mcous/beer2d2/pcb/r2dbrew-front-pcb/r2dbrew-front-pcb.pdf

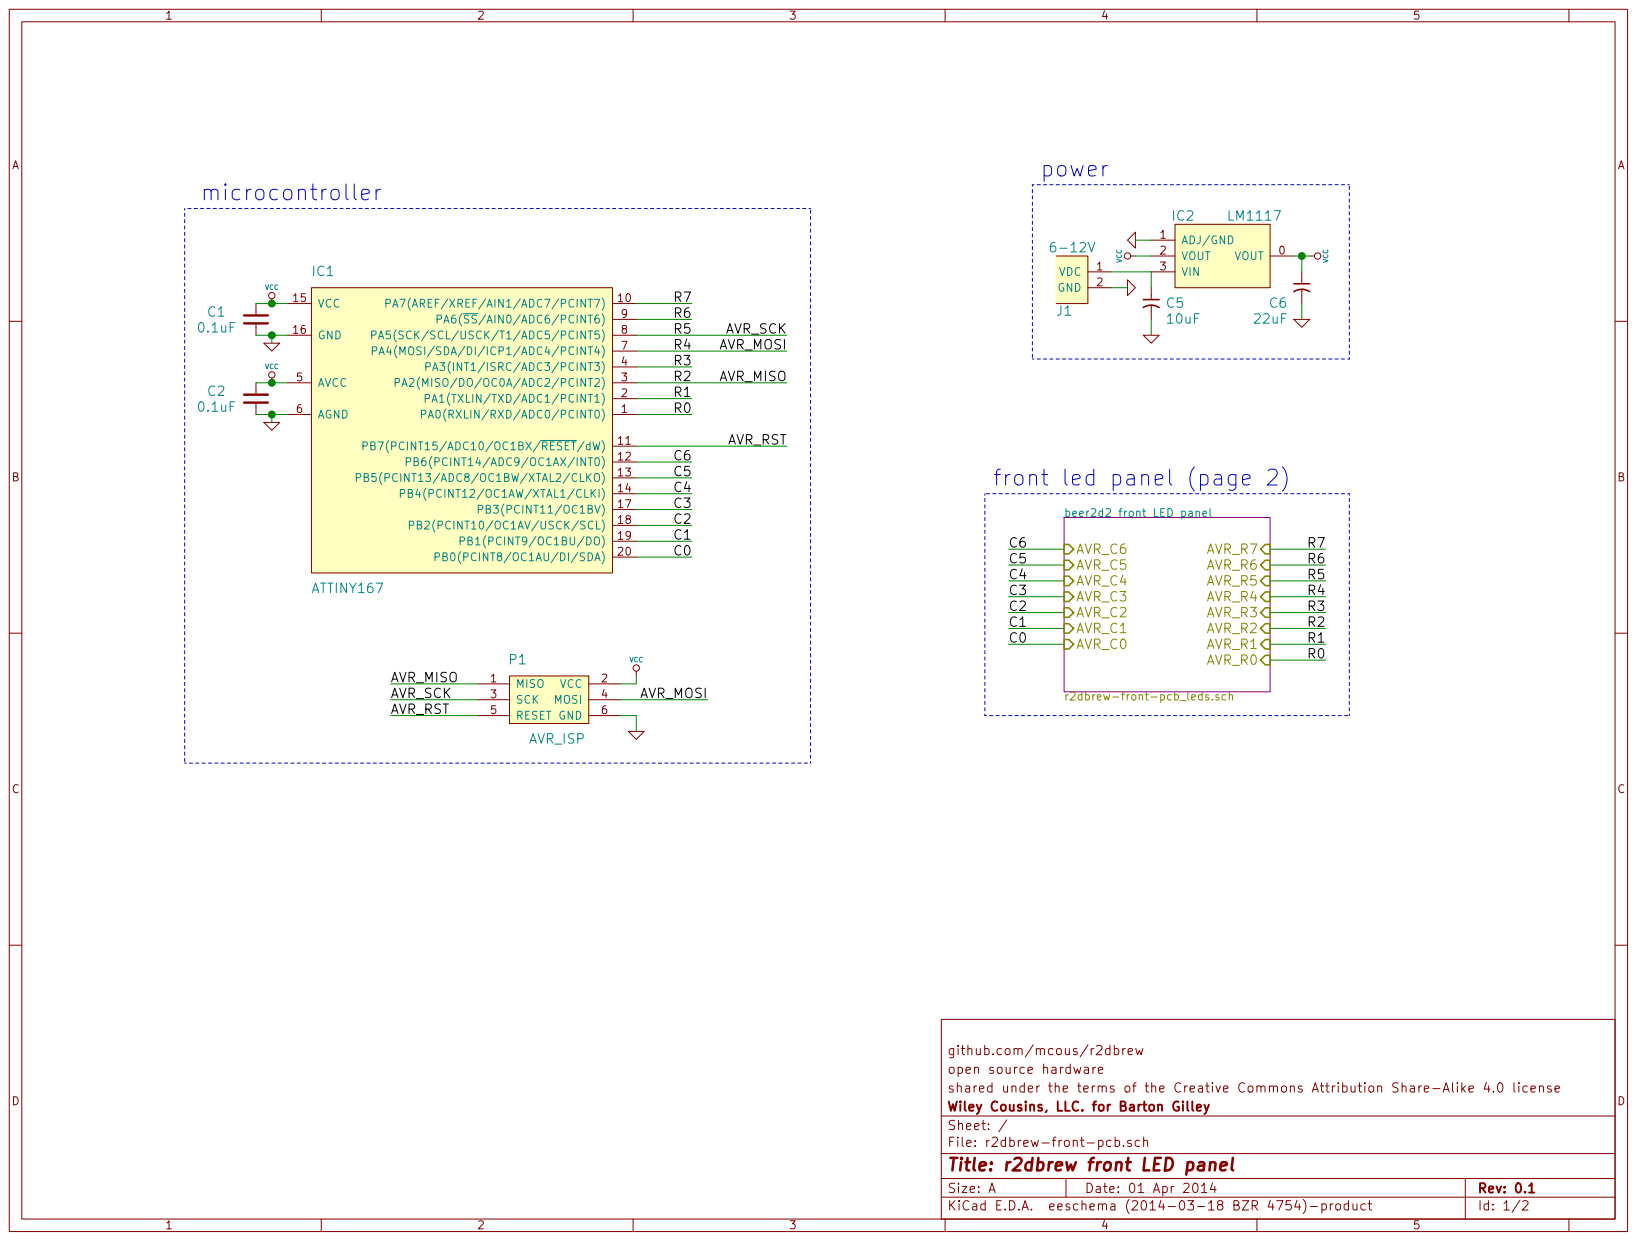
[picture p1: page 1]

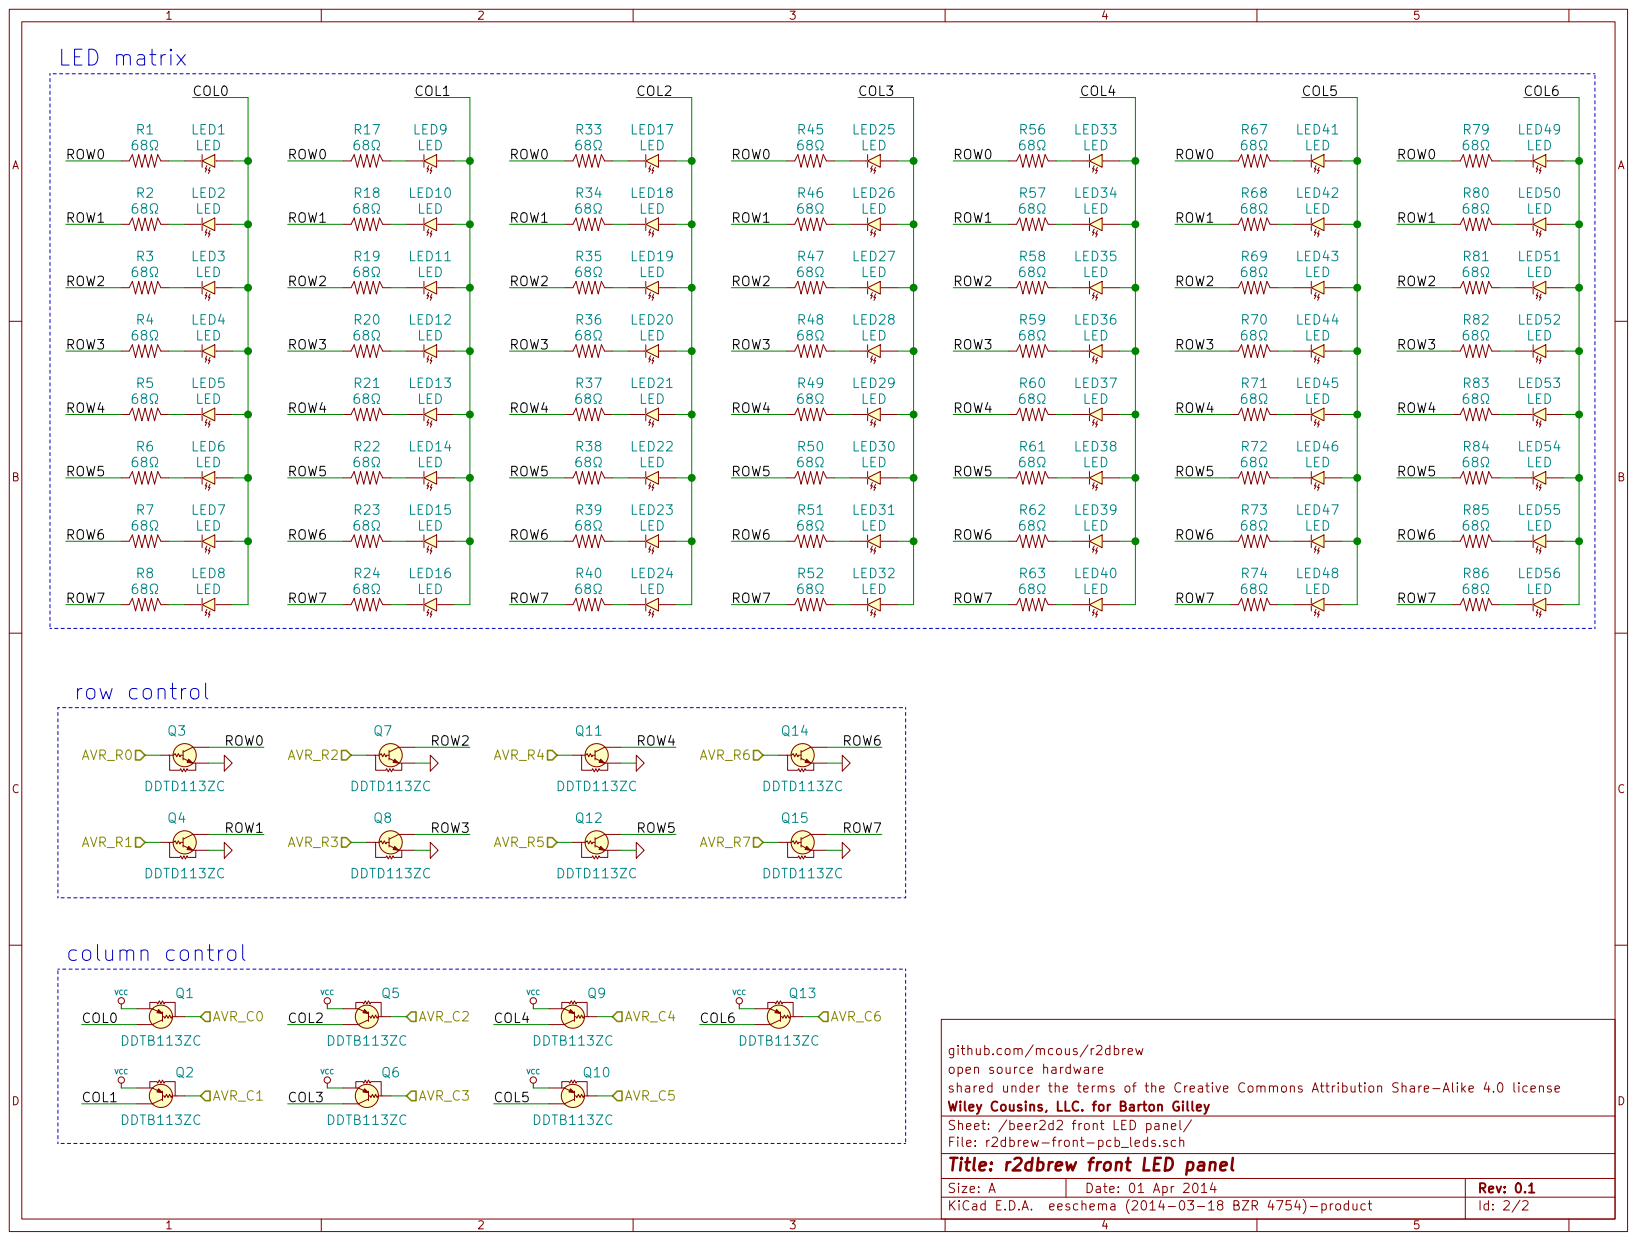
[picture p2: page 2]
