mcous/beer2d2/pcb/r2dbrew-back-pcb/r2dbrew-back-pcb.pdf

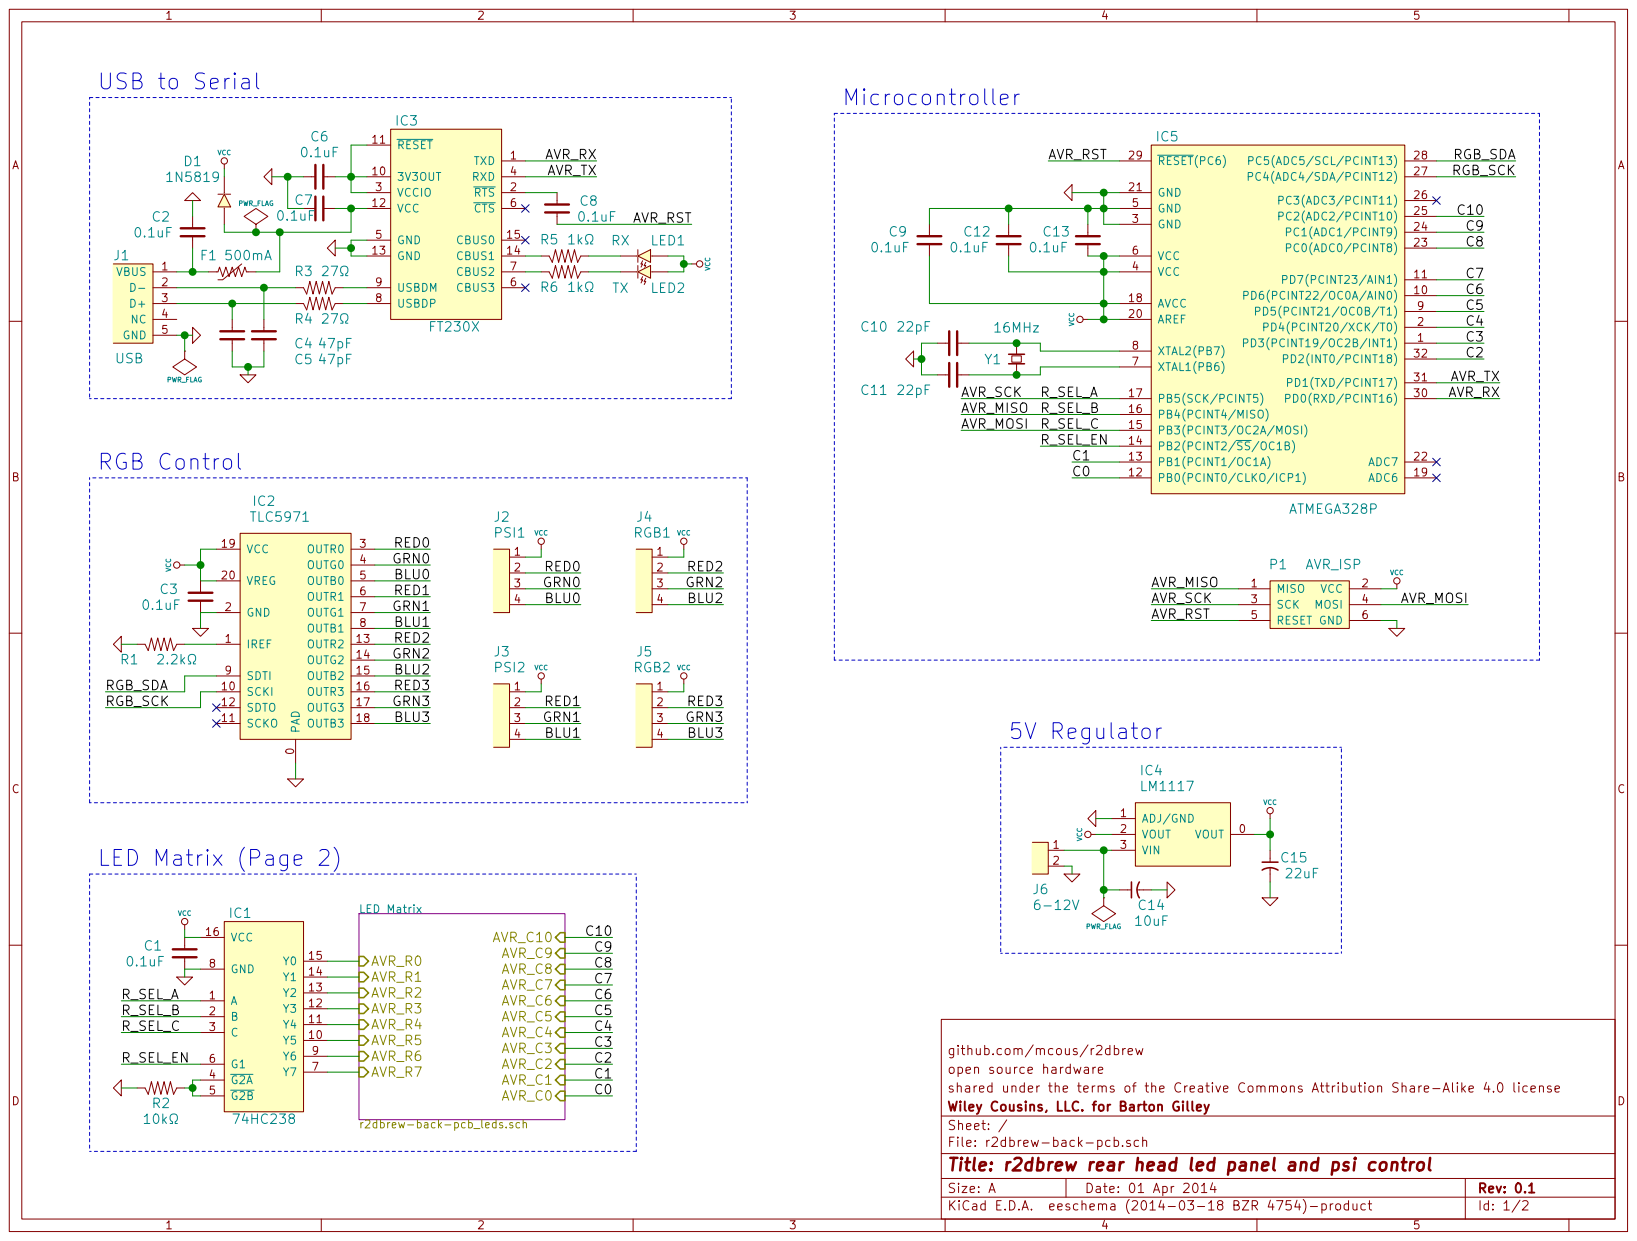
[picture p3: page 1]

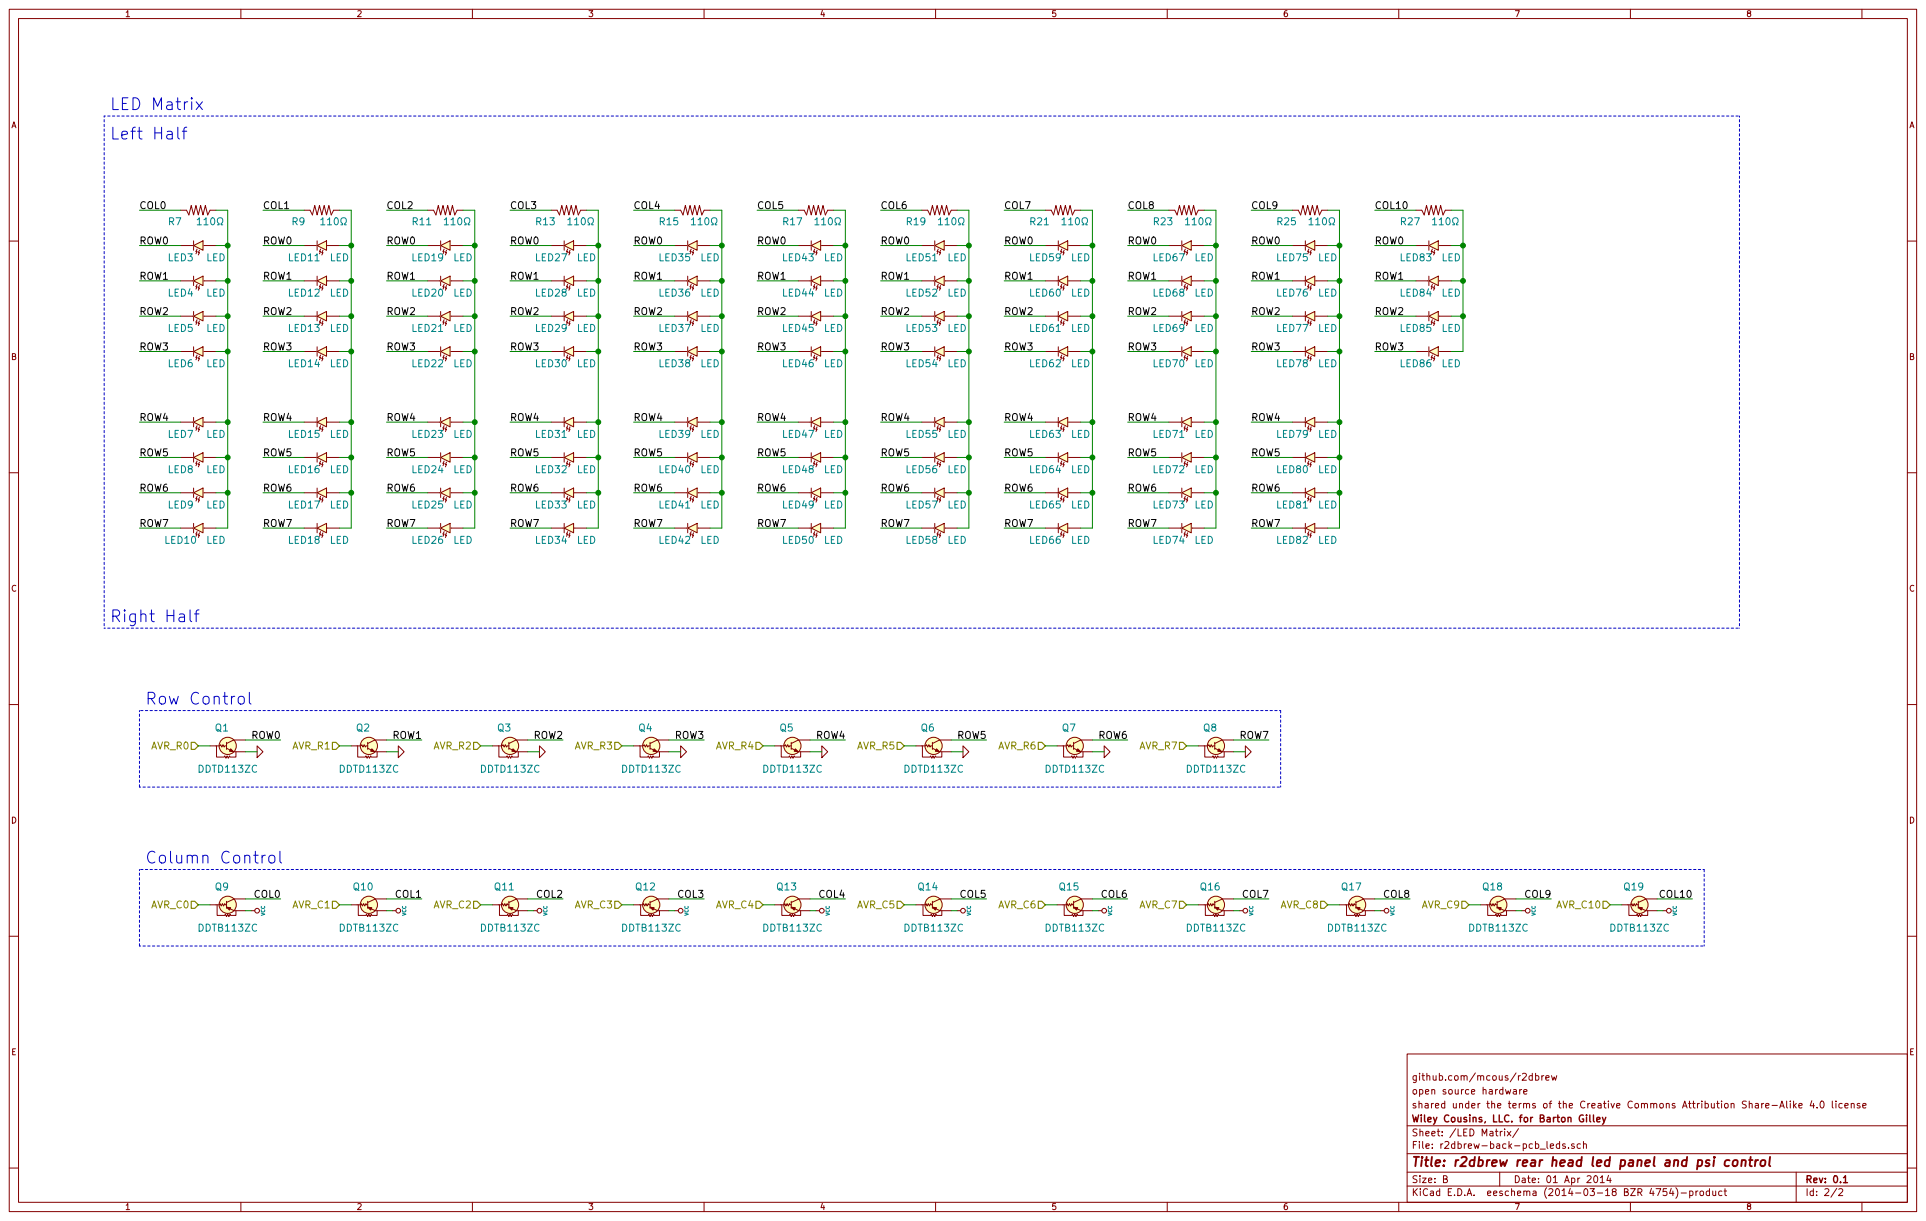
[picture p4: page 2]
