mcous/beer2d2/pcb/r2dbrew-back-pcb/r2dbrew-back-pcb.kicad_pcb

## KiCad design pcb/r2dbrew-back-pcb/r2dbrew-back-pcb.kicad_pcb (2014-05-03)

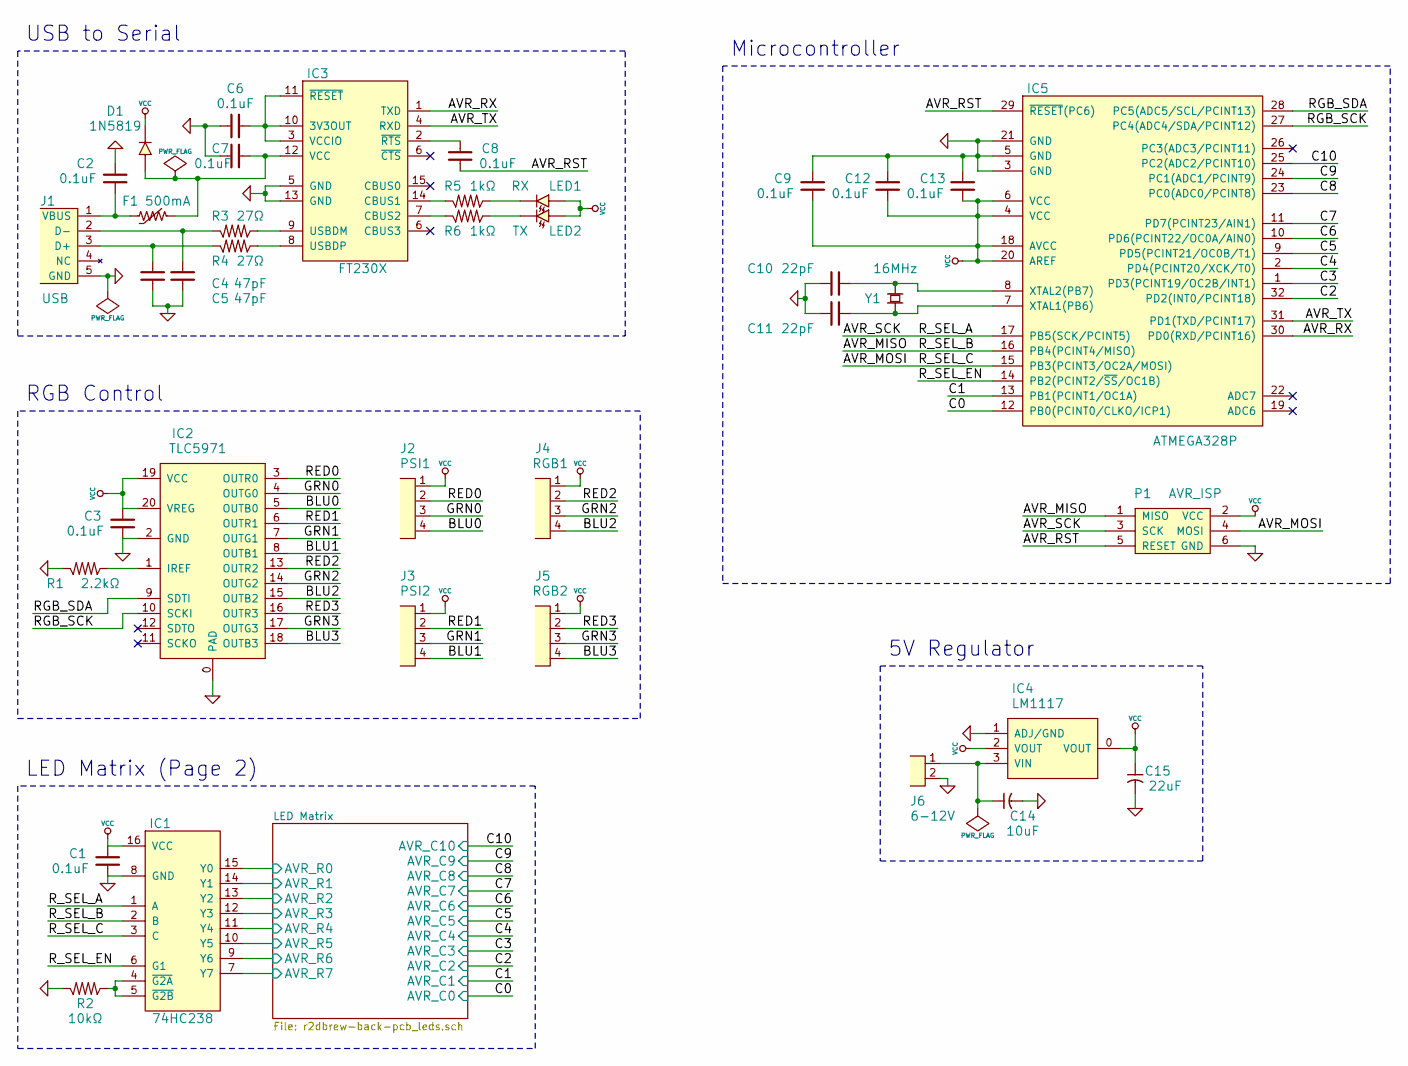
[picture p5: schematic r2dbrew-back-pcb.sch, r2dbrew rear head led panel and psi control]

Parts:
C1, C2, C3, C6, C7, C8, C9, C12, C13: 0.1uF
C4, C5: 47pF
C10, C11: 22pF
C14: 10uF
C15: 22uF
D1: 1N5819
F1: 500mA
IC1: 74HC238
IC2: TLC5971; Part TLC5971PWP
IC3: FT230X
IC4: LM1117
IC5: ATMEGA328P
J1: USB
J2: PSI1
J3: PSI2
J4: RGB1
J5: RGB2
J6: 6-12V
LED1: RX
LED2: TX
P1: AVR_ISP
R1: 2.2kΩ
R2: 10kΩ
R3, R4: 27Ω
R5, R6: 1kΩ
Y1: 16MHz

Connections:
/AVR_MISO: IC1.2 (B), IC5.16 (PB4(PCINT4/MISO)), P1.1 (MISO)
/AVR_MOSI: IC1.3 (C), IC5.15 (PB3(PCINT3/OC2A/MOSI)), P1.4 (MOSI)
/AVR_RST: C8.1, IC5.29 (~RESET~(PC6)), P1.5 (RESET)
/AVR_RX: IC3.1 (TXD), IC5.30 (PD0(RXD/PCINT16))
/AVR_SCK: IC1.1 (A), IC5.17 (PB5(SCK/PCINT5)), P1.3 (SCK)
/AVR_TX: IC3.4 (RXD), IC5.31 (PD1(TXD/PCINT17))
/BLU0: IC2.5 (OUTB0), J2.4
/BLU1: IC2.8 (OUTB1), J3.4
/BLU2: IC2.15 (OUTB2), J4.4
/BLU3: IC2.18 (OUTB3), J5.4
/GRN0: IC2.4 (OUTG0), J2.3
/GRN1: IC2.7 (OUTG1), J3.3
/GRN2: IC2.14 (OUTG2), J4.3
/GRN3: IC2.17 (OUTG3), J5.3
/LED Matrix/AVR_C0: IC5.12 (PB0(PCINT0/CLKO/ICP1)); also elsewhere on the board
/LED Matrix/AVR_C1: IC5.13 (PB1(PCINT1/OC1A)); also elsewhere on the board
/LED Matrix/AVR_C2: IC5.32 (PD2(INT0/PCINT18)); also elsewhere on the board
/LED Matrix/AVR_C3: IC5.1 (PD3(PCINT19/OC2B/INT1)); also elsewhere on the board
/LED Matrix/AVR_C4: IC5.2 (PD4(PCINT20/XCK/T0)); also elsewhere on the board
/LED Matrix/AVR_C5: IC5.9 (PD5(PCINT21/OC0B/T1)); also elsewhere on the board
/LED Matrix/AVR_C6: IC5.10 (PD6(PCINT22/OC0A/AIN0)); also elsewhere on the board
/LED Matrix/AVR_C7: IC5.11 (PD7(PCINT23/AIN1)); also elsewhere on the board
/LED Matrix/AVR_C8: IC5.23 (PC0(ADC0/PCINT8)); also elsewhere on the board
/LED Matrix/AVR_C9: IC5.24 (PC1(ADC1/PCINT9)); also elsewhere on the board
/LED Matrix/AVR_C10: IC5.25 (PC2(ADC2/PCINT10)); also elsewhere on the board
/LED Matrix/AVR_R0: IC1.15 (Y0); also elsewhere on the board
/LED Matrix/AVR_R1: IC1.14 (Y1); also elsewhere on the board
/LED Matrix/AVR_R2: IC1.13 (Y2); also elsewhere on the board
/LED Matrix/AVR_R3: IC1.12 (Y3); also elsewhere on the board
/LED Matrix/AVR_R4: IC1.11 (Y4); also elsewhere on the board
/LED Matrix/AVR_R5: IC1.10 (Y5); also elsewhere on the board
/LED Matrix/AVR_R6: IC1.9 (Y6); also elsewhere on the board
/LED Matrix/AVR_R7: IC1.7 (Y7); also elsewhere on the board
/RED0: IC2.3 (OUTR0), J2.2
/RED1: IC2.6 (OUTR1), J3.2
/RED2: IC2.13 (OUTR2), J4.2
/RED3: IC2.16 (OUTR3), J5.2
/RGB_SCK: IC2.10 (SCKI), IC5.27 (PC4(ADC4/SDA/PCINT12))
/RGB_SDA: IC2.9 (SDTI), IC5.28 (PC5(ADC5/SCL/PCINT13))
/R_SEL_EN: IC1.6 (G1), IC5.14 (PB2(PCINT2/~SS~/OC1B))
GND: C1.1, C2.2, C3.1, C4.1, C5.1, C6.1, C7.1, C9.1, C10.1, C11.1, C12.1, C13.1, C14.2, C15.2, IC1.8 (GND), IC2.0 (PAD), IC2.2 (GND), IC3.5 (GND), IC3.13 (GND), IC4.1 (ADJ/GND), IC5.3 (GND), IC5.5 (GND), IC5.21 (GND), J1.5 (GND), J6.2, P1.6 (GND), R1.1, R2.1; also elsewhere on the board
unnamed: C2.1, F1.1, J1.1 (VBUS)
unnamed: C4.2, J1.3 (D+), R4.1
unnamed: C5.2, J1.2 (D-), R3.1
unnamed: C6.2, IC3.3 (VCCIO), IC3.10 (3V3OUT), IC3.11 (~RESET~)
unnamed: C7.2, D1.2 (A), F1.2, IC3.12 (VCC)
unnamed: C8.2, IC3.2 (~RTS~)
unnamed: C10.2, IC5.8 (XTAL2(PB7)), Y1.2
unnamed: C11.2, IC5.7 (XTAL1(PB6)), Y1.1
unnamed: C14.1, IC4.3 (VIN), J6.1
unnamed: IC1.4 (~G2A~), IC1.5 (~G2B~), R2.2
unnamed: IC2.1 (IREF), R1.2
unnamed: IC3.7 (CBUS2), R6.1
unnamed: IC3.8 (USBDP), R4.2
unnamed: IC3.9 (USBDM), R3.2
unnamed: IC3.14 (CBUS1), R5.1
unnamed: LED1.1 (C), R5.2
unnamed: LED2.1 (C), R6.2
VCC: C1.2, C3.2, C9.2, C12.2, C13.2, C15.1, D1.1 (C), IC1.16 (VCC), IC2.19 (VCC), IC2.20 (VREG), IC4.0 (VOUT), IC4.2 (VOUT), IC5.4 (VCC), IC5.6 (VCC), IC5.18 (AVCC), IC5.20 (AREF), J2.1, J3.1, J4.1, J5.1, LED1.2 (A), LED2.2 (A), P1.2 (VCC); also elsewhere on the board

Notes on the sheet:
LED Matrix (Page 2)
RGB Control
USB to Serial
Microcontroller
5V Regulator

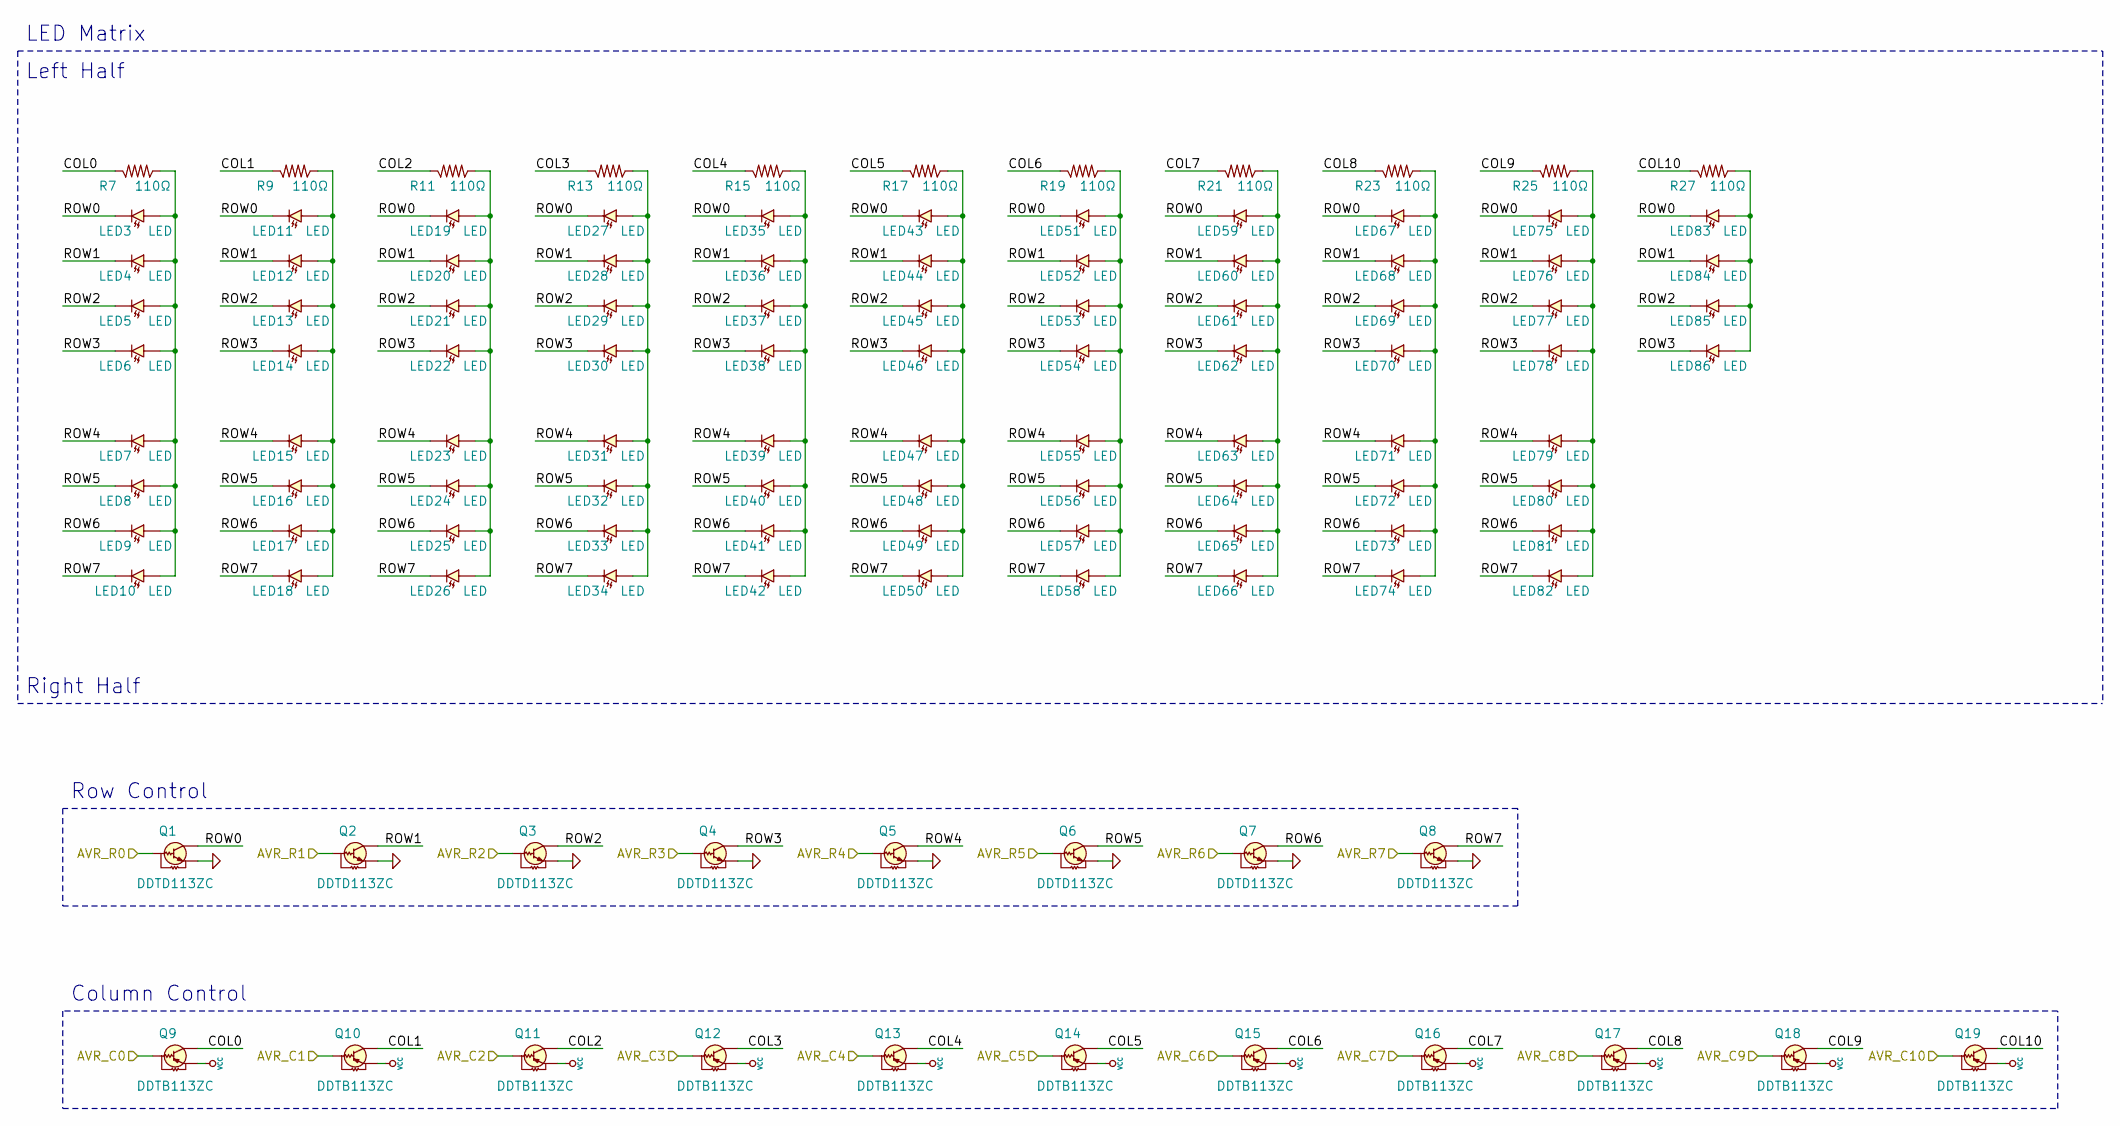
[picture p6: schematic r2dbrew-back-pcb_leds.sch, r2dbrew rear head led panel and psi control]

Parts:
LED3, LED4, LED5, LED6, LED7, LED8, LED9, LED10, LED11, LED12, LED13, LED14, LED15, LED16, LED17, LED18, LED19, LED20, LED21, LED22, LED23, LED24, LED25, LED26, LED27, LED28, LED29, LED30, LED31, LED32, LED33, LED34, LED35, LED36, LED37, LED38, LED39, LED40, LED41, LED42, LED43, LED44, LED45, LED46, LED47, LED48, LED49, LED50, LED51, LED52, LED53, LED54, LED55, LED56, LED57, LED58, LED59, LED60, LED61, LED62, LED63, LED64, LED65, LED66, LED67, LED68, LED69, LED70, LED71, LED72, LED73, LED74, LED75, LED76, LED77, LED78, LED79, LED80, LED81, LED82, LED83, LED84, LED85, LED86: LED
Q1, Q2, Q3, Q4, Q5, Q6, Q7, Q8: DDTD113ZC
Q9, Q10, Q11, Q12, Q13, Q14, Q15, Q16, Q17, Q18, Q19: DDTB113ZC
R7, R9, R11, R13, R15, R17, R19, R21, R23, R25, R27: 110Ω

Connections:
/LED Matrix/AVR_C0: Q9.1 (B); also elsewhere on the board
/LED Matrix/AVR_C1: Q10.1 (B); also elsewhere on the board
/LED Matrix/AVR_C2: Q11.1 (B); also elsewhere on the board
/LED Matrix/AVR_C3: Q12.1 (B); also elsewhere on the board
/LED Matrix/AVR_C4: Q13.1 (B); also elsewhere on the board
/LED Matrix/AVR_C5: Q14.1 (B); also elsewhere on the board
/LED Matrix/AVR_C6: Q15.1 (B); also elsewhere on the board
/LED Matrix/AVR_C7: Q16.1 (B); also elsewhere on the board
/LED Matrix/AVR_C8: Q17.1 (B); also elsewhere on the board
/LED Matrix/AVR_C9: Q18.1 (B); also elsewhere on the board
/LED Matrix/AVR_C10: Q19.1 (B); also elsewhere on the board
/LED Matrix/AVR_R0: Q1.1 (B); also elsewhere on the board
/LED Matrix/AVR_R1: Q2.1 (B); also elsewhere on the board
/LED Matrix/AVR_R2: Q3.1 (B); also elsewhere on the board
/LED Matrix/AVR_R3: Q4.1 (B); also elsewhere on the board
/LED Matrix/AVR_R4: Q5.1 (B); also elsewhere on the board
/LED Matrix/AVR_R5: Q6.1 (B); also elsewhere on the board
/LED Matrix/AVR_R6: Q7.1 (B); also elsewhere on the board
/LED Matrix/AVR_R7: Q8.1 (B); also elsewhere on the board
/LED Matrix/COL0: Q9.3 (C), R7.1
/LED Matrix/COL1: Q10.3 (C), R9.1
/LED Matrix/COL2: Q11.3 (C), R11.1
/LED Matrix/COL3: Q12.3 (C), R13.1
/LED Matrix/COL4: Q13.3 (C), R15.1
/LED Matrix/COL5: Q14.3 (C), R17.1
/LED Matrix/COL6: Q15.3 (C), R19.1
/LED Matrix/COL7: Q16.3 (C), R21.1
/LED Matrix/COL8: Q17.3 (C), R23.1
/LED Matrix/COL9: Q18.3 (C), R25.1
/LED Matrix/COL10: Q19.3 (C), R27.1
/LED Matrix/ROW0: LED3.1 (C), LED11.1 (C), LED19.1 (C), LED27.1 (C), LED35.1 (C), LED43.1 (C), LED51.1 (C), LED59.1 (C), LED67.1 (C), LED75.1 (C), LED83.1 (C), Q1.3 (C)
/LED Matrix/ROW1: LED4.1 (C), LED12.1 (C), LED20.1 (C), LED28.1 (C), LED36.1 (C), LED44.1 (C), LED52.1 (C), LED60.1 (C), LED68.1 (C), LED76.1 (C), LED84.1 (C), Q2.3 (C)
/LED Matrix/ROW2: LED5.1 (C), LED13.1 (C), LED21.1 (C), LED29.1 (C), LED37.1 (C), LED45.1 (C), LED53.1 (C), LED61.1 (C), LED69.1 (C), LED77.1 (C), LED85.1 (C), Q3.3 (C)
/LED Matrix/ROW3: LED6.1 (C), LED14.1 (C), LED22.1 (C), LED30.1 (C), LED38.1 (C), LED46.1 (C), LED54.1 (C), LED62.1 (C), LED70.1 (C), LED78.1 (C), LED86.1 (C), Q4.3 (C)
/LED Matrix/ROW4: LED7.1 (C), LED15.1 (C), LED23.1 (C), LED31.1 (C), LED39.1 (C), LED47.1 (C), LED55.1 (C), LED63.1 (C), LED71.1 (C), LED79.1 (C), Q5.3 (C)
/LED Matrix/ROW5: LED8.1 (C), LED16.1 (C), LED24.1 (C), LED32.1 (C), LED40.1 (C), LED48.1 (C), LED56.1 (C), LED64.1 (C), LED72.1 (C), LED80.1 (C), Q6.3 (C)
/LED Matrix/ROW6: LED9.1 (C), LED17.1 (C), LED25.1 (C), LED33.1 (C), LED41.1 (C), LED49.1 (C), LED57.1 (C), LED65.1 (C), LED73.1 (C), LED81.1 (C), Q7.3 (C)
/LED Matrix/ROW7: LED10.1 (C), LED18.1 (C), LED26.1 (C), LED34.1 (C), LED42.1 (C), LED50.1 (C), LED58.1 (C), LED66.1 (C), LED74.1 (C), LED82.1 (C), Q8.3 (C)
GND: Q1.2 (E), Q2.2 (E), Q3.2 (E), Q4.2 (E), Q5.2 (E), Q6.2 (E), Q7.2 (E), Q8.2 (E); also elsewhere on the board
unnamed: LED3.2 (A), LED4.2 (A), LED5.2 (A), LED6.2 (A), LED7.2 (A), LED8.2 (A), LED9.2 (A), LED10.2 (A), R7.2
unnamed: LED11.2 (A), LED12.2 (A), LED13.2 (A), LED14.2 (A), LED15.2 (A), LED16.2 (A), LED17.2 (A), LED18.2 (A), R9.2
unnamed: LED19.2 (A), LED20.2 (A), LED21.2 (A), LED22.2 (A), LED23.2 (A), LED24.2 (A), LED25.2 (A), LED26.2 (A), R11.2
unnamed: LED27.2 (A), LED28.2 (A), LED29.2 (A), LED30.2 (A), LED31.2 (A), LED32.2 (A), LED33.2 (A), LED34.2 (A), R13.2
unnamed: LED35.2 (A), LED36.2 (A), LED37.2 (A), LED38.2 (A), LED39.2 (A), LED40.2 (A), LED41.2 (A), LED42.2 (A), R15.2
unnamed: LED43.2 (A), LED44.2 (A), LED45.2 (A), LED46.2 (A), LED47.2 (A), LED48.2 (A), LED49.2 (A), LED50.2 (A), R17.2
unnamed: LED51.2 (A), LED52.2 (A), LED53.2 (A), LED54.2 (A), LED55.2 (A), LED56.2 (A), LED57.2 (A), LED58.2 (A), R19.2
unnamed: LED59.2 (A), LED60.2 (A), LED61.2 (A), LED62.2 (A), LED63.2 (A), LED64.2 (A), LED65.2 (A), LED66.2 (A), R21.2
unnamed: LED67.2 (A), LED68.2 (A), LED69.2 (A), LED70.2 (A), LED71.2 (A), LED72.2 (A), LED73.2 (A), LED74.2 (A), R23.2
unnamed: LED75.2 (A), LED76.2 (A), LED77.2 (A), LED78.2 (A), LED79.2 (A), LED80.2 (A), LED81.2 (A), LED82.2 (A), R25.2
unnamed: LED83.2 (A), LED84.2 (A), LED85.2 (A), LED86.2 (A), R27.2
VCC: Q9.2 (E), Q10.2 (E), Q11.2 (E), Q12.2 (E), Q13.2 (E), Q14.2 (E), Q15.2 (E), Q16.2 (E), Q17.2 (E), Q18.2 (E), Q19.2 (E); also elsewhere on the board

Notes on the sheet:
LED Matrix
Right Half
Row Control
Column Control
Left Half

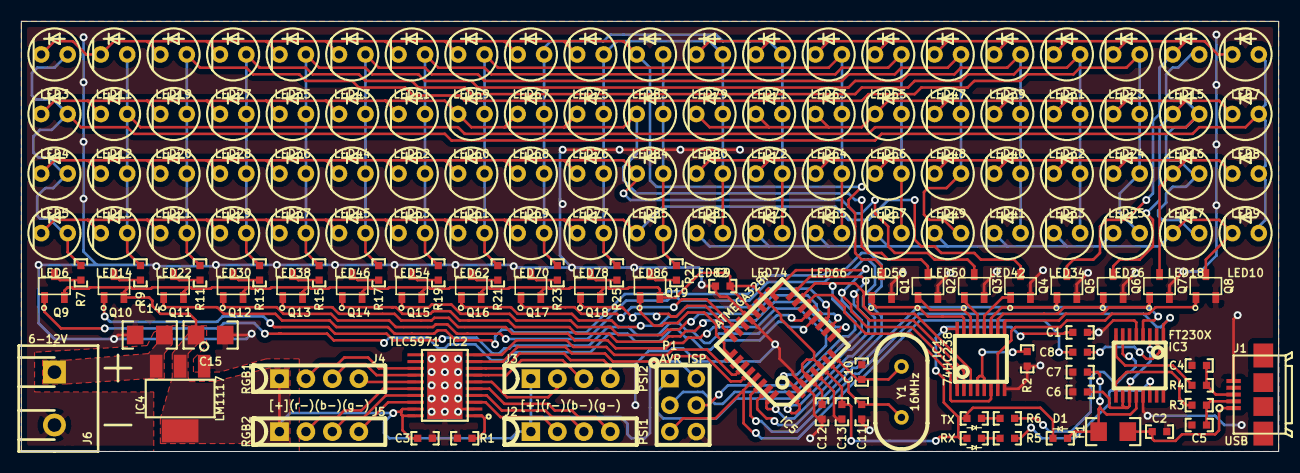
[picture p7: board r2dbrew-back-pcb.kicad_pcb from above]

Board: 2 copper layers, 120.6 x 41.3 mm, 152 parts (0 on the bottom side), 89 nets.
