mcous/beer2d2/pcb/r2dbrew-front-pcb/r2dbrew-front-pcb.kicad_pcb

## KiCad design pcb/r2dbrew-front-pcb/r2dbrew-front-pcb.kicad_pcb (2014-04-02)

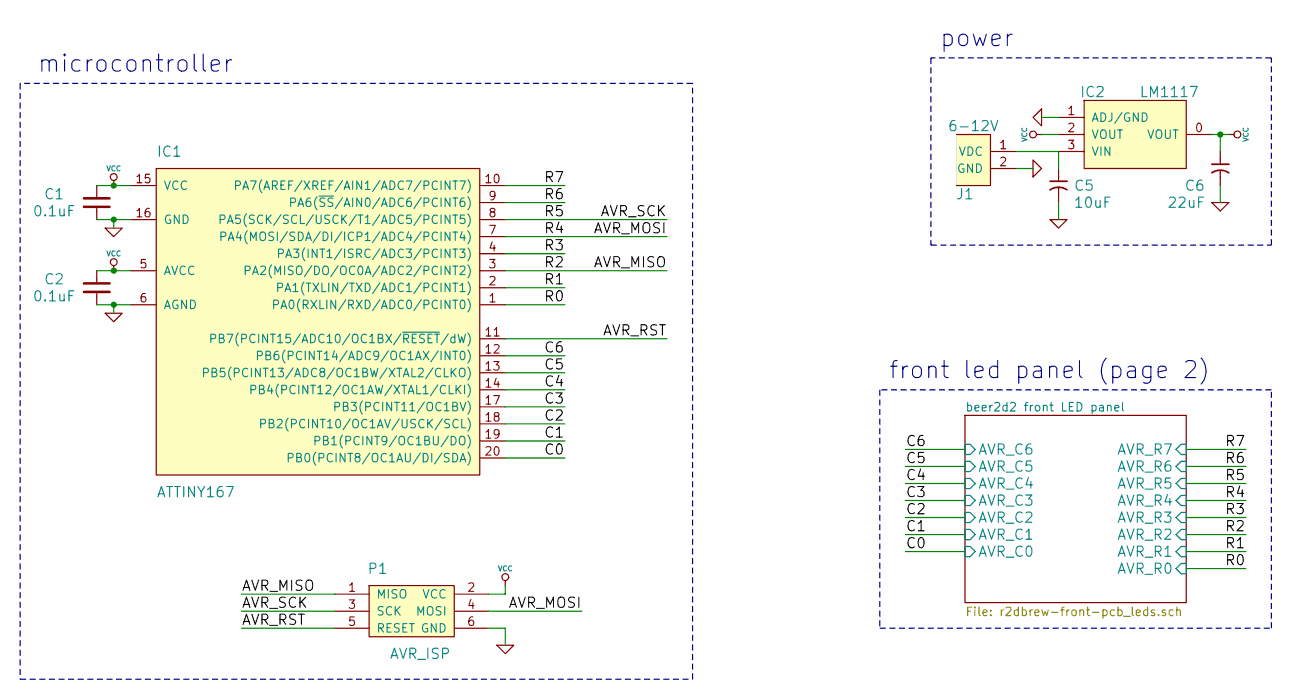
[picture p8: schematic r2dbrew-front-pcb.sch, r2dbrew front LED panel]

Parts:
C1, C2: 0.1uF
C5: 10uF
C6: 22uF
IC1: ATTINY167
IC2: LM1117
J1: 6-12V
P1: AVR_ISP

Connections:
/AVR_RST: IC1.11 (PB7(PCINT15/ADC10/OC1BX/~RESET~/dW)), P1.5 (RESET)
/beer2d2 front LED panel/AVR_C0: IC1.20 (PB0(PCINT8/OC1AU/DI/SDA)); also elsewhere on the board
/beer2d2 front LED panel/AVR_C1: IC1.19 (PB1(PCINT9/OC1BU/DO)); also elsewhere on the board
/beer2d2 front LED panel/AVR_C2: IC1.18 (PB2(PCINT10/OC1AV/USCK/SCL)); also elsewhere on the board
/beer2d2 front LED panel/AVR_C3: IC1.17 (PB3(PCINT11/OC1BV)); also elsewhere on the board
/beer2d2 front LED panel/AVR_C4: IC1.14 (PB4(PCINT12/OC1AW/XTAL1/CLKI)); also elsewhere on the board
/beer2d2 front LED panel/AVR_C5: IC1.13 (PB5(PCINT13/ADC8/OC1BW/XTAL2/CLKO)); also elsewhere on the board
/beer2d2 front LED panel/AVR_C6: IC1.12 (PB6(PCINT14/ADC9/OC1AX/INT0)); also elsewhere on the board
/beer2d2 front LED panel/AVR_R0: IC1.1 (PA0(RXLIN/RXD/ADC0/PCINT0)); also elsewhere on the board
/beer2d2 front LED panel/AVR_R1: IC1.2 (PA1(TXLIN/TXD/ADC1/PCINT1)); also elsewhere on the board
/beer2d2 front LED panel/AVR_R2: IC1.3 (PA2(MISO/DO/OC0A/ADC2/PCINT2)), P1.1 (MISO); also elsewhere on the board
/beer2d2 front LED panel/AVR_R3: IC1.4 (PA3(INT1/ISRC/ADC3/PCINT3)); also elsewhere on the board
/beer2d2 front LED panel/AVR_R4: IC1.7 (PA4(MOSI/SDA/DI/ICP1/ADC4/PCINT4)), P1.4 (MOSI); also elsewhere on the board
/beer2d2 front LED panel/AVR_R5: IC1.8 (PA5(SCK/SCL/USCK/T1/ADC5/PCINT5)), P1.3 (SCK); also elsewhere on the board
/beer2d2 front LED panel/AVR_R6: IC1.9 (PA6(~SS~/AIN0/ADC6/PCINT6)); also elsewhere on the board
/beer2d2 front LED panel/AVR_R7: IC1.10 (PA7(AREF/XREF/AIN1/ADC7/PCINT7)); also elsewhere on the board
GND: C1.1, C2.1, C5.2, C6.2, IC1.6 (AGND), IC1.16 (GND), IC2.1 (ADJ/GND), J1.2 (GND), P1.6 (GND); also elsewhere on the board
unnamed: C5.1, IC2.3 (VIN), J1.1 (VDC)
VCC: C1.2, C2.2, C6.1, IC1.5 (AVCC), IC1.15 (VCC), IC2.0 (VOUT), IC2.2 (VOUT), P1.2 (VCC); also elsewhere on the board

Notes on the sheet:
power
microcontroller
front led panel (page 2)

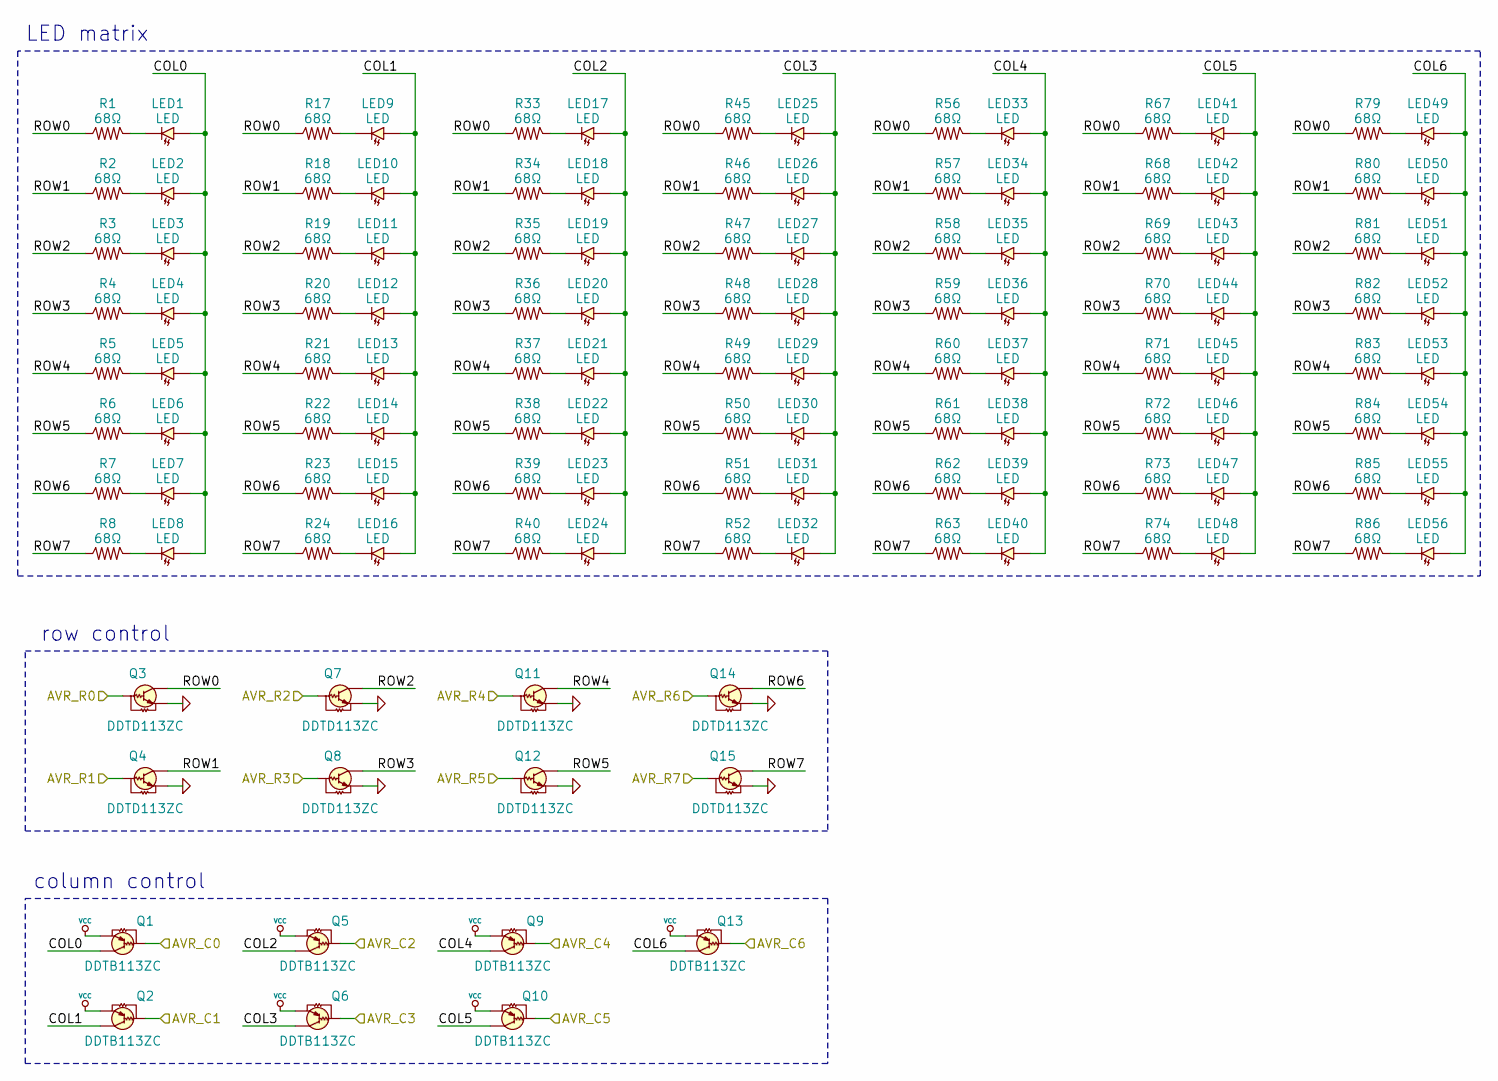
[picture p9: schematic r2dbrew-front-pcb_leds.sch, r2dbrew front LED panel]

Parts:
LED1, LED2, LED3, LED4, LED5, LED6, LED7, LED8, LED9, LED10, LED11, LED12, LED13, LED14, LED15, LED16, LED17, LED18, LED19, LED20, LED21, LED22, LED23, LED24, LED25, LED26, LED27, LED28, LED29, LED30, LED31, LED32, LED33, LED34, LED35, LED36, LED37, LED38, LED39, LED40, LED41, LED42, LED43, LED44, LED45, LED46, LED47, LED48, LED49, LED50, LED51, LED52, LED53, LED54, LED55, LED56: LED
Q1, Q2, Q5, Q6, Q9, Q10, Q13: DDTB113ZC; Part DDTB113ZC-7-F
Q3, Q4, Q7, Q8, Q11, Q12, Q14, Q15: DDTD113ZC; Part DDTD113ZC-7-F
R1, R2, R3, R4, R5, R6, R7, R8, R17, R18, R19, R20, R21, R22, R23, R24, R33, R34, R35, R36, R37, R38, R39, R40, R45, R46, R47, R48, R49, R50, R51, R52, R56, R57, R58, R59, R60, R61, R62, R63, R67, R68, R69, R70, R71, R72, R73, R74, R79, R80, R81, R82, R83, R84, R85, R86: 68Ω; Part RC1608J680CS

Connections:
/beer2d2 front LED panel/AVR_C0: Q1.1 (B); also elsewhere on the board
/beer2d2 front LED panel/AVR_C1: Q2.1 (B); also elsewhere on the board
/beer2d2 front LED panel/AVR_C2: Q5.1 (B); also elsewhere on the board
/beer2d2 front LED panel/AVR_C3: Q6.1 (B); also elsewhere on the board
/beer2d2 front LED panel/AVR_C4: Q9.1 (B); also elsewhere on the board
/beer2d2 front LED panel/AVR_C5: Q10.1 (B); also elsewhere on the board
/beer2d2 front LED panel/AVR_C6: Q13.1 (B); also elsewhere on the board
/beer2d2 front LED panel/AVR_R0: Q3.1 (B); also elsewhere on the board
/beer2d2 front LED panel/AVR_R1: Q4.1 (B); also elsewhere on the board
/beer2d2 front LED panel/AVR_R2: Q7.1 (B); also elsewhere on the board
/beer2d2 front LED panel/AVR_R3: Q8.1 (B); also elsewhere on the board
/beer2d2 front LED panel/AVR_R4: Q11.1 (B); also elsewhere on the board
/beer2d2 front LED panel/AVR_R5: Q12.1 (B); also elsewhere on the board
/beer2d2 front LED panel/AVR_R6: Q14.1 (B); also elsewhere on the board
/beer2d2 front LED panel/AVR_R7: Q15.1 (B); also elsewhere on the board
/beer2d2 front LED panel/COL0: LED1.2 (A), LED2.2 (A), LED3.2 (A), LED4.2 (A), LED5.2 (A), LED6.2 (A), LED7.2 (A), LED8.2 (A), Q1.3 (C)
/beer2d2 front LED panel/COL1: LED9.2 (A), LED10.2 (A), LED11.2 (A), LED12.2 (A), LED13.2 (A), LED14.2 (A), LED15.2 (A), LED16.2 (A), Q2.3 (C)
/beer2d2 front LED panel/COL2: LED17.2 (A), LED18.2 (A), LED19.2 (A), LED20.2 (A), LED21.2 (A), LED22.2 (A), LED23.2 (A), LED24.2 (A), Q5.3 (C)
/beer2d2 front LED panel/COL3: LED25.2 (A), LED26.2 (A), LED27.2 (A), LED28.2 (A), LED29.2 (A), LED30.2 (A), LED31.2 (A), LED32.2 (A), Q6.3 (C)
/beer2d2 front LED panel/COL4: LED33.2 (A), LED34.2 (A), LED35.2 (A), LED36.2 (A), LED37.2 (A), LED38.2 (A), LED39.2 (A), LED40.2 (A), Q9.3 (C)
/beer2d2 front LED panel/COL5: LED41.2 (A), LED42.2 (A), LED43.2 (A), LED44.2 (A), LED45.2 (A), LED46.2 (A), LED47.2 (A), LED48.2 (A), Q10.3 (C)
/beer2d2 front LED panel/COL6: LED49.2 (A), LED50.2 (A), LED51.2 (A), LED52.2 (A), LED53.2 (A), LED54.2 (A), LED55.2 (A), LED56.2 (A), Q13.3 (C)
/beer2d2 front LED panel/ROW0: Q3.3 (C), R1.2, R17.2, R33.2, R45.2, R56.2, R67.2, R79.2
/beer2d2 front LED panel/ROW1: Q4.3 (C), R2.2, R18.2, R34.2, R46.2, R57.2, R68.2, R80.2
/beer2d2 front LED panel/ROW2: Q7.3 (C), R3.2, R19.2, R35.2, R47.2, R58.2, R69.2, R81.2
/beer2d2 front LED panel/ROW3: Q8.3 (C), R4.2, R20.2, R36.2, R48.2, R59.2, R70.2, R82.2
/beer2d2 front LED panel/ROW4: Q11.3 (C), R5.2, R21.2, R37.2, R49.2, R60.2, R71.2, R83.2
/beer2d2 front LED panel/ROW5: Q12.3 (C), R6.2, R22.2, R38.2, R50.2, R61.2, R72.2, R84.2
/beer2d2 front LED panel/ROW6: Q14.3 (C), R7.2, R23.2, R39.2, R51.2, R62.2, R73.2, R85.2
/beer2d2 front LED panel/ROW7: Q15.3 (C), R8.2, R24.2, R40.2, R52.2, R63.2, R74.2, R86.2
GND: Q3.2 (E), Q4.2 (E), Q7.2 (E), Q8.2 (E), Q11.2 (E), Q12.2 (E), Q14.2 (E), Q15.2 (E); also elsewhere on the board
unnamed: LED1.1 (C), R1.1
unnamed: LED2.1 (C), R2.1
unnamed: LED3.1 (C), R3.1
unnamed: LED4.1 (C), R4.1
unnamed: LED5.1 (C), R5.1
unnamed: LED6.1 (C), R6.1
unnamed: LED7.1 (C), R7.1
unnamed: LED8.1 (C), R8.1
unnamed: LED9.1 (C), R17.1
unnamed: LED10.1 (C), R18.1
unnamed: LED11.1 (C), R19.1
unnamed: LED12.1 (C), R20.1
unnamed: LED13.1 (C), R21.1
unnamed: LED14.1 (C), R22.1
unnamed: LED15.1 (C), R23.1
unnamed: LED16.1 (C), R24.1
unnamed: LED17.1 (C), R33.1
unnamed: LED18.1 (C), R34.1
unnamed: LED19.1 (C), R35.1
unnamed: LED20.1 (C), R36.1
unnamed: LED21.1 (C), R37.1
unnamed: LED22.1 (C), R38.1
unnamed: LED23.1 (C), R39.1
unnamed: LED24.1 (C), R40.1
unnamed: LED25.1 (C), R45.1
unnamed: LED26.1 (C), R46.1
unnamed: LED27.1 (C), R47.1
unnamed: LED28.1 (C), R48.1
unnamed: LED29.1 (C), R49.1
unnamed: LED30.1 (C), R50.1
unnamed: LED31.1 (C), R51.1
unnamed: LED32.1 (C), R52.1
unnamed: LED33.1 (C), R56.1
unnamed: LED34.1 (C), R57.1
unnamed: LED35.1 (C), R58.1
unnamed: LED36.1 (C), R59.1
unnamed: LED37.1 (C), R60.1
unnamed: LED38.1 (C), R61.1
unnamed: LED39.1 (C), R62.1
unnamed: LED40.1 (C), R63.1
unnamed: LED41.1 (C), R67.1
unnamed: LED42.1 (C), R68.1
unnamed: LED43.1 (C), R69.1
unnamed: LED44.1 (C), R70.1
unnamed: LED45.1 (C), R71.1
unnamed: LED46.1 (C), R72.1
unnamed: LED47.1 (C), R73.1
unnamed: LED48.1 (C), R74.1
unnamed: LED49.1 (C), R79.1
unnamed: LED50.1 (C), R80.1
unnamed: LED51.1 (C), R81.1
unnamed: LED52.1 (C), R82.1
unnamed: LED53.1 (C), R83.1
unnamed: LED54.1 (C), R84.1
unnamed: LED55.1 (C), R85.1
unnamed: LED56.1 (C), R86.1
VCC: Q1.2 (E), Q2.2 (E), Q5.2 (E), Q6.2 (E), Q9.2 (E), Q10.2 (E), Q13.2 (E); also elsewhere on the board

Notes on the sheet:
row control
column control
LED matrix

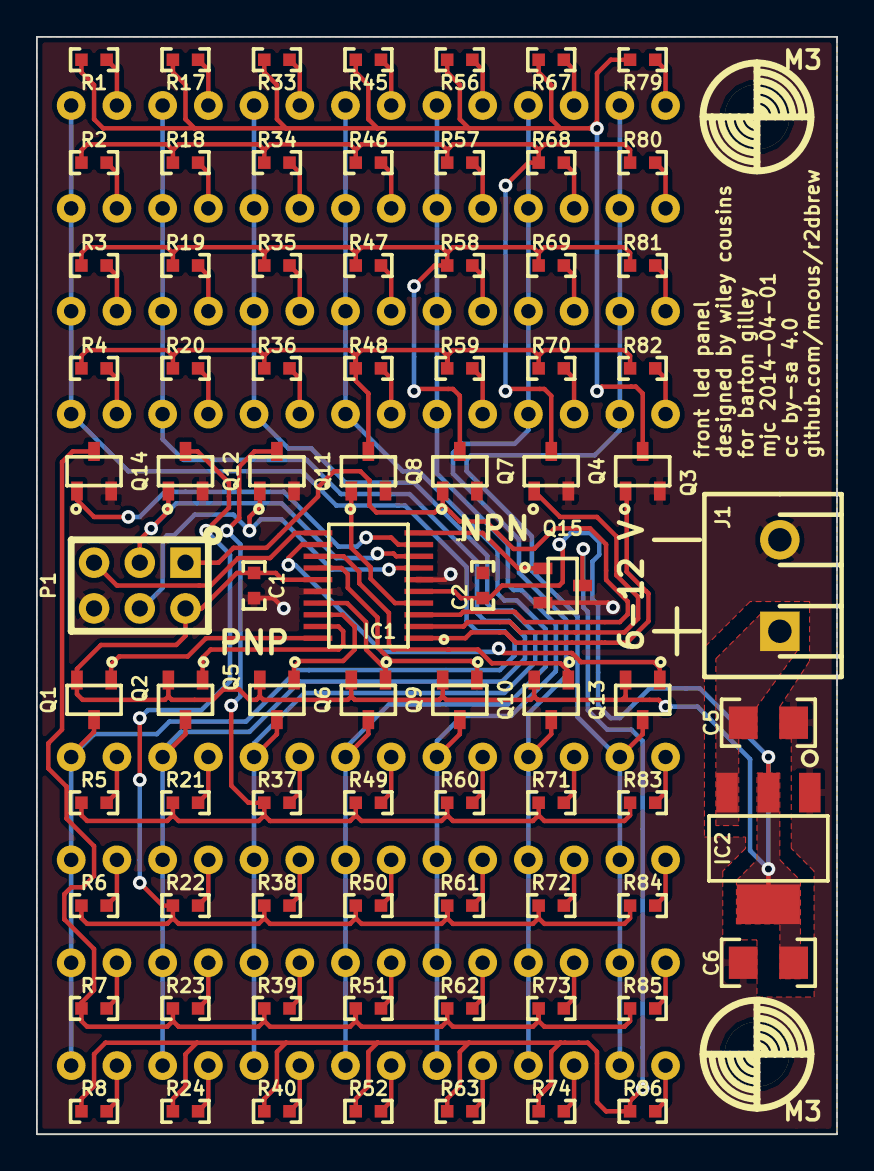
[picture p10: board r2dbrew-front-pcb.kicad_pcb from above]

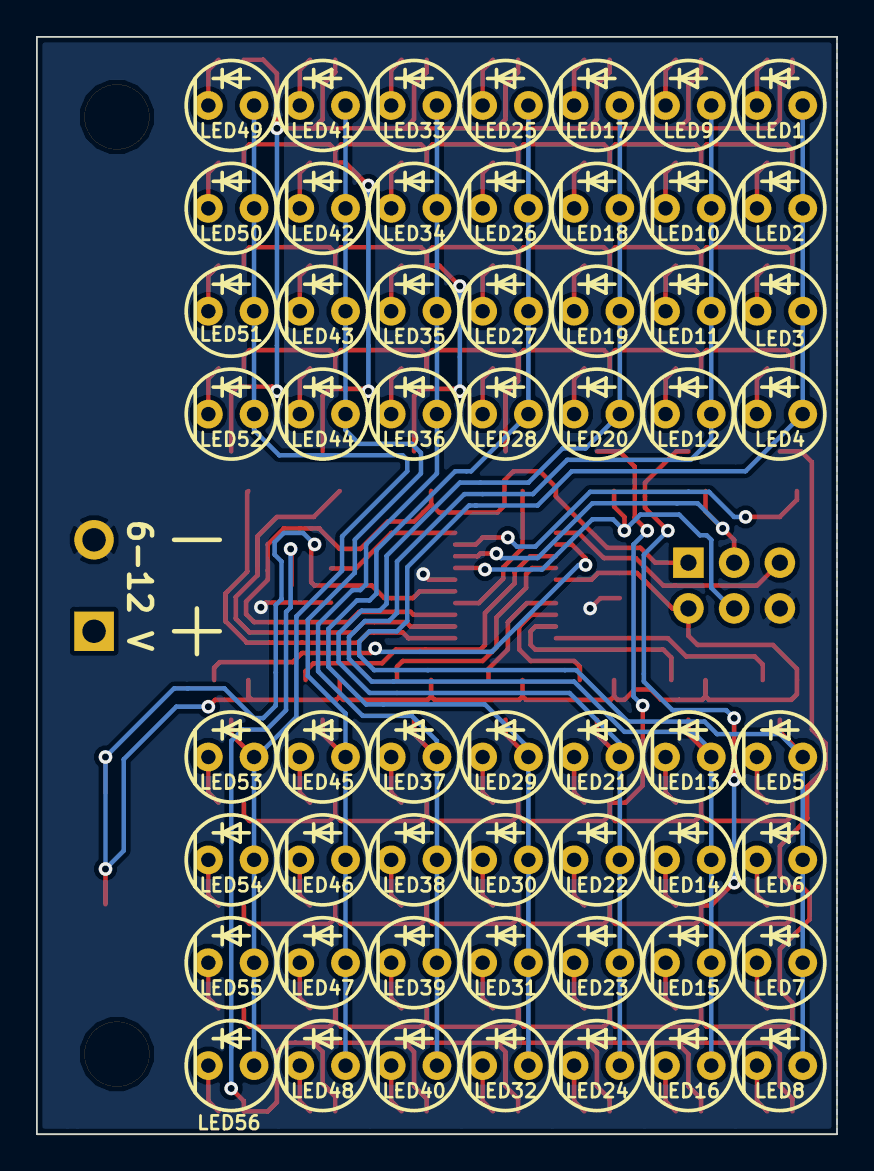
[picture p11: board r2dbrew-front-pcb.kicad_pcb from below]

Board: 2 copper layers, 44.5 x 61.0 mm, 137 parts (56 on the bottom side), 90 nets.

Other parts of the board:
M3, M3#2: VAL**; M3
