mcous/beer2d2/firmware/back/pindefs.h

#ifndef R2DBREW_BACK_PINDEFS_H
#define R2DBREW_BACK_PINDEFS_H

#include <avr/io.h>

#define TLC_N 1
#define TLC_MOSI_PORT PORTC
#define TLC_MOSI_PIN 5
#define TLC_SCK_PORT PORTC
#define TLC_SCK_PIN 4

#endif
