mcous/beer2d2/firmware/back/TLC5971.h

// clockblock
// Copyright 2013 by Wiley Cousins, LLC.
// shared under the terms of the MIT License
//
// file: TLC5971.h
// description: header for TLC5971 LED-driver

#ifndef LIB_TLC5971_H
#define LIB_TLC5971_H

// typedefs (uint8_t's all day long baby)
#include <stdint.h>

// function control defines (function control is the 5 MSb's of the data package)
#define TLC5971_BLANK   (1<<0)
#define TLC5971_DSPRPT  (1<<1)
#define TLC5971_TMGRST  (1<<2)
#define TLC5971_EXTGCK  (1<<3)
#define TLC5971_OUTTMG  (1<<4)


class TLC5971 {
public:
  // constructor takes number of drivers daisychained on one serial line and the pindefs
  TLC5971();
  // initialization routine
  void init();
  // control the chip(s)
  // parameters
  //   - *gs: array of n*12 uint16_t for greyscale data (PWM)
  //   - *bc: array of 3 uint8_t for brightness correction
  //   - fc: uint8_t for function control
  void setGS(uint16_t *g);
  void setBC(uint8_t b);
  void setBC(uint8_t *b);
  void setFC(uint8_t f);
private:
  // serial helpers
  // send the write command to the device (6-bits = 0x25 = 0b100101)
  void sendWriteCommand();
  // send the function control packet
  void sendFC();
  // send the brightness control
  void sendBC();
  // send the greyscale
  void sendGS();
  // send n bits from a data byte
  void sendData(uint8_t data, uint8_t n);

  // control registers
  // function control
  uint8_t fc;
  // brightness control
  uint8_t bc[3];

  // buffer pointers
  // greyscale control
  uint16_t *gs;

  // number of drivers
  // uint8_t num;

  // pin defs
  // volatile uint8_t *sckPort;
  // uint8_t sckPin;
  // volatile uint8_t *mosiPort;
  // uint8_t mosiPin;
};

#endif
