mcous/beer2d2/(commit log)

2013-11-12 getting some thoughts on "paper"
    [beer2d2-pcb.sch]
2013-11-12 initial schematic pass
    [beer2d2-pcb.sch, beer2d2-pcb_front-panel.sch]
2013-11-12 changing file names and directory structure around
    [beer2d2-front-pcb.sch, beer2d2-front-pcb_leds.sch]
2013-11-12 fixed up the files after rename
    [beer2d2-front-pcb.sch, beer2d2-front-pcb_leds.sch]
2013-11-13 first pass at board layout. will probably try again
    [beer2d2-front-pcb.kicad_pcb, beer2d2-front-pcb.sch, beer2d2-front-pcb_leds.sch]
2013-11-13 taking another board pass
    [beer2d2-front-pcb.kicad_pcb]
2013-11-13 liking this placement a lot more
    [beer2d2-front-pcb.kicad_pcb, beer2d2-front-pcb.sch, beer2d2-front-pcb_leds.sch]
2014-01-22 about to redo a bunch of stuff
    [beer2d2-front-pcb.kicad_pcb]
2014-01-22 redoing front board
    [beer2d2-front-pcb.kicad_pcb, beer2d2-front-pcb.sch, beer2d2-front-pcb_leds.sch]
2014-01-24 layout complete
    [beer2d2-front-pcb.kicad_pcb, beer2d2-front-pcb.sch, beer2d2-front-pcb_leds.sch]
2014-01-24 board layout done safety commit
2014-01-24 moving on to rear pcb
    [beer2d2-front-pcb.sch, beer2d2-front-pcb_leds.sch]
2014-01-24 back pcb schematic pass 1 done
    [beer2d2-back-pcb.kicad_pcb, beer2d2-back-pcb.sch, beer2d2-back-pcb_leds.sch]
2014-01-25 well, that wasn't so easy
    [beer2d2-back-pcb.kicad_pcb, beer2d2-back-pcb.sch, beer2d2-back-pcb_leds.sch]
2014-01-28 tentative placement layout
    [beer2d2-back-pcb.kicad_pcb, beer2d2-back-pcb.sch, beer2d2-back-pcb_leds.sch]
2014-03-20 continue routing for back pcb
    [beer2d2-back-pcb.kicad_pcb, beer2d2-back-pcb.sch, beer2d2-back-pcb_leds.sch]
2014-03-20 commit for safety
    [beer2d2-back-pcb.kicad_pcb]
2014-03-20 commit for dinner
    [beer2d2-back-pcb.kicad_pcb]
2014-04-01 layout back board copper
    [beer2d2-back-pcb.kicad_pcb, beer2d2-back-pcb.sch]
2014-04-01 layout finished
    [beer2d2-back-pcb.kicad_pcb]
2014-04-01 fix voltage regulator cap values and footprints
    [beer2d2-back-pcb.kicad_pcb, beer2d2-back-pcb.sch]
2014-04-01 finish back layout and rename project
    [r2dbrew-back-pcb.kicad_pcb, r2dbrew-back-pcb.sch, r2dbrew-back-pcb_leds.sch]
2014-04-01 cleanup after project rename
    [r2dbrew-back-pcb.kicad_pcb, r2dbrew-back-pcb.sch, r2dbrew-back-pcb_leds.sch]
2014-04-01 add read pcb schematic and gerber plots
    [beer2d2-back-pcb-B_Cu.gbl, beer2d2-back-pcb-B_Mask.gbs, beer2d2-back-pcb-B_SilkS.gbo, beer2d2-back-pcb-Edge_Cuts.gbr, beer2d2-back-pcb-F_Cu.gtl, beer2d2-back-pcb-F_Mask.gts, beer2d2-back-pcb-F_SilkS.gto, beer2d2-back-pcb.drl]
2014-04-02 rename front board to new project name
    [r2dbrew-front-pcb.kicad_pcb, r2dbrew-front-pcb.sch, r2dbrew-front-pcb_leds.sch]
2014-04-02 cleanup files after rename and prepare for plotting
    [r2dbrew-front-pcb.kicad_pcb, r2dbrew-front-pcb.sch, r2dbrew-front-pcb_leds.sch]
2014-04-02 add gerber plots for front board
    [r2dbrew-front-pcb-B_Cu.gbl, r2dbrew-front-pcb-B_Mask.gbs, r2dbrew-front-pcb-B_SilkS.gbo, r2dbrew-front-pcb-Edge_Cuts.gbr, r2dbrew-front-pcb-F_Cu.gtl, r2dbrew-front-pcb-F_Mask.gts, r2dbrew-front-pcb-F_SilkS.gto, r2dbrew-front-pcb.drl]
2014-04-02 fix rear silkscreen and mask clearance
    [r2dbrew-front-pcb-B_Cu.gbl, r2dbrew-front-pcb-B_Mask.gbs, r2dbrew-front-pcb-B_SilkS.gbo, r2dbrew-front-pcb-Edge_Cuts.gbr, r2dbrew-front-pcb-F_Cu.gtl, r2dbrew-front-pcb-F_Mask.gts, r2dbrew-front-pcb-F_SilkS.gto, r2dbrew-front-pcb.drl]
2014-04-02 fix ic2 missing from silkscreen
    [r2dbrew-front-pcb.kicad_pcb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]
2014-04-02 fix mask clearance for back board
    [r2dbrew-back-pcb.kicad_pcb]
2014-04-02 rename plots to new project name
    [beer2d2-back-pcb-B_Cu.gbl, beer2d2-back-pcb-B_Mask.gbs, beer2d2-back-pcb-B_SilkS.gbo, beer2d2-back-pcb-Edge_Cuts.gbr, beer2d2-back-pcb-F_Cu.gtl, beer2d2-back-pcb-F_Mask.gts, beer2d2-back-pcb-F_SilkS.gto, beer2d2-back-pcb.drl]
2014-04-02 add back panel plots with correct names
    [r2dbrew-back-pcb-B_Cu.gbl, r2dbrew-back-pcb-B_Mask.gbs, r2dbrew-back-pcb-B_SilkS.gbo, r2dbrew-back-pcb-Edge_Cuts.gbr, r2dbrew-back-pcb-F_Cu.gtl, r2dbrew-back-pcb-F_Mask.gts, r2dbrew-back-pcb-F_SilkS.gto, r2dbrew-back-pcb.drl]
2014-05-03 add back pcb bom in csv format;
    [r2dbrew-back-pcb-bom.csv]
2014-05-03 add front pcb bom in csv format
    [r2dbrew-front-pcb-bom.csv]
2014-05-03 add initial front led panel firmware
2014-05-03 switch back leds to proper orientation. fixes #1
    [r2dbrew-back-pcb.kicad_pcb]
