mcous/beer2d2/(notices)

Notices in the files:
pcb/r2dbrew-back-pcb/r2dbrew-back-pcb_leds.sch:
shared under the terms of the Creative Commons Attribution Share-Alike 4.0 license
pcb/r2dbrew-front-pcb/r2dbrew-front-pcb.kicad_pcb:
released under the terms of the CC BY-SA 4.0 license
cc by-sa 4.0
pcb/r2dbrew-back-pcb/r2dbrew-back-pcb.kicad_pcb:
shared under the terms of the Creative Commes BY-SA 4.0 License
open source hardware: cc by-sa 4.0
